nicotakuya/attiny2313-videoout/videoout2313_schematics.png

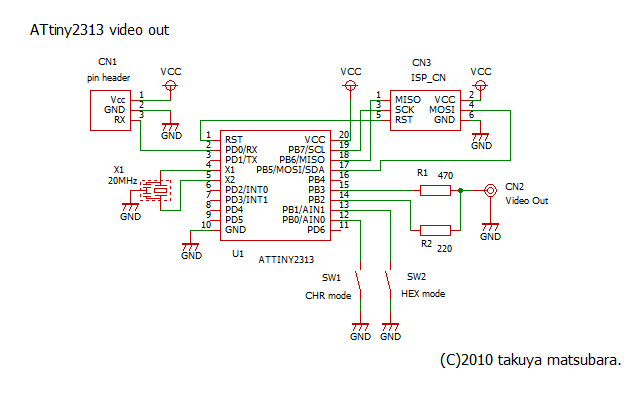
videoout2313_schematics.png
