nicotakuya/attiny2313-videoout/videoout_example_schematics.png

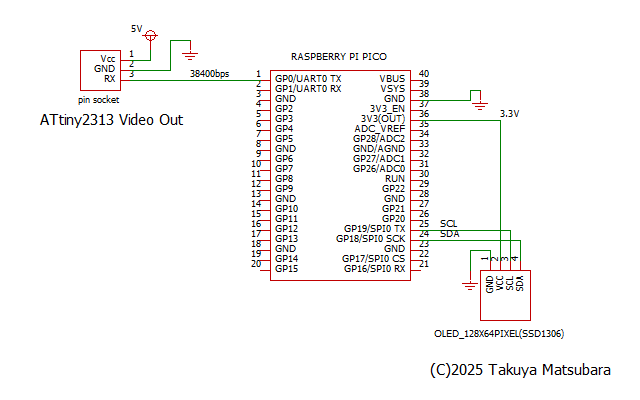
videoout_example_schematics.png
