nicotakuya/attiny2313-videoout/vout2313/sfont.h

// small font
// by takuya matsubara

const unsigned char smallfont[] PROGMEM ={
    0x00,0x00,0x00,    /* 0x20   */
    0x04,0x44,0x04,    /* 0x21 ! */
    0x0a,0xa0,0x00,    /* 0x22 " */
    0x04,0xe4,0xe4,    /* 0x23 # */
    0x04,0xec,0x6c,    /* 0x24 $ */
    0x08,0x24,0x82,    /* 0x25 % */
    0x04,0xac,0xa6,    /* 0x26 & */
    0x04,0x80,0x00,    /* 0x27 ' */
    0x04,0x88,0x84,    /* 0x28 ( */
    0x04,0x22,0x24,    /* 0x29 ) */
    0x0a,0x4e,0x4a,    /* 0x2A * */
    0x04,0x4e,0x44,    /* 0x2B + */
    0x00,0x00,0x48,    /* 0x2C , */
    0x00,0x0e,0x00,    /* 0x2D - */
    0x00,0x00,0x04,    /* 0x2E . */
    0x02,0x44,0x48,    /* 0x2F / */
    0x04,0xaa,0xa4,    /* 0x30 0 */
    0x02,0x62,0x22,    /* 0x31 1 */
    0x0c,0x24,0x8e,    /* 0x32 2 */
    0x0c,0x2c,0x2c,    /* 0x33 3 */
    0x0a,0xae,0x22,    /* 0x34 4 */
    0x0e,0x8c,0x2c,    /* 0x35 5 */
    0x06,0x8c,0xa4,    /* 0x36 6 */
    0x0e,0x22,0x48,    /* 0x37 7 */
    0x04,0xa4,0xa4,    /* 0x38 8 */
    0x04,0xa6,0x2c,    /* 0x39 9 */
    0x00,0x40,0x40,    /* 0x3A : */
    0x00,0x40,0x48,    /* 0x3B ; */
    0x02,0x48,0x42,    /* 0x3C < */
    0x00,0xe0,0xe0,    /* 0x3D = */
    0x08,0x42,0x48,    /* 0x3E > */
    0x0c,0x24,0x04,    /* 0x3F ? */
    0x0e,0x2e,0xae,    /* 0x40 @ */
    0x04,0xaa,0xea,    /* 0x41 A */
    0x0c,0xac,0xac,    /* 0x42 B */
    0x06,0x88,0x86,    /* 0x43 C */
    0x0c,0xaa,0xac,    /* 0x44 D */
    0x0e,0x8e,0x8e,    /* 0x45 E */
    0x0e,0x8e,0x88,    /* 0x46 F */
    0x06,0x8a,0xa6,    /* 0x47 G */
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
};
